LeoDJ/ledCollar/README.md

# LED Collar

### [PCB Documentation](ledCollar_PCB)

## Project Installation
Make sure to run `git clone` with `--recurse-submodules` to include the necessary libraries too.
