LeoDJ/ledCollar/ledCollar_PCB/README.md

# LED Collar PCB

### [Schematic PDF](ledCollar_PCB.pdf)
### [Interactive BOM](https://leodj.github.io/ledCollar/ledCollar_PCB/doc/ledCollar_PCB-ibom.html)

## Pictures

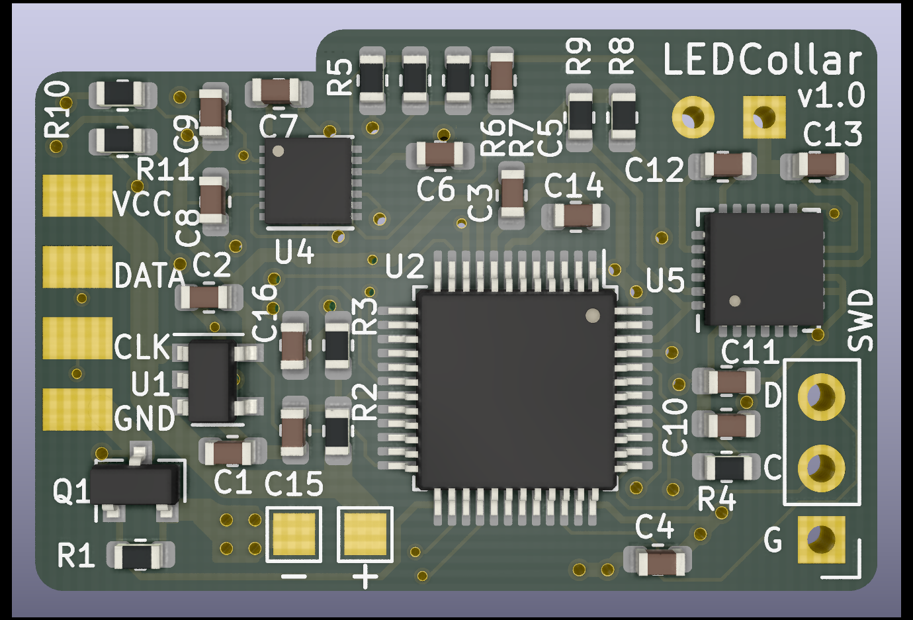
[picture p1: ledCollar_PCB/doc/1top.png]
front
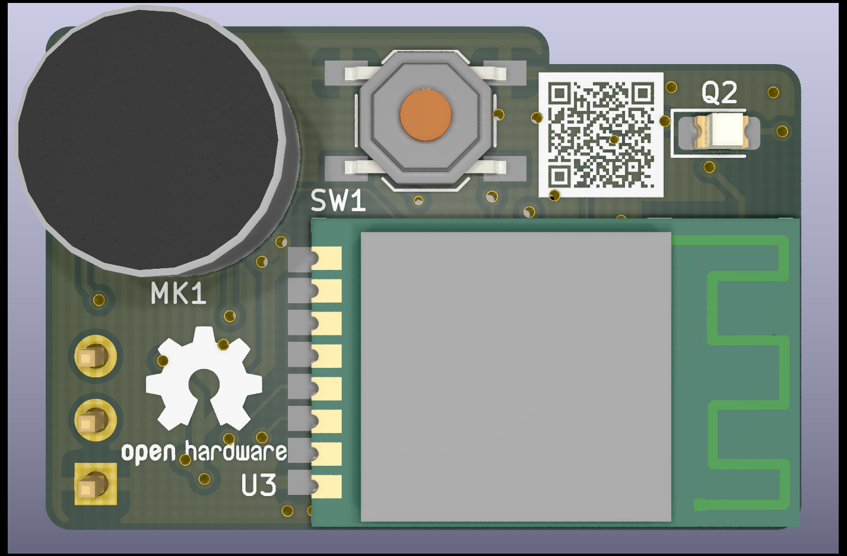
[picture p2: ledCollar_PCB/doc/1bot.png]
back
|  |  |
| --- | --- |
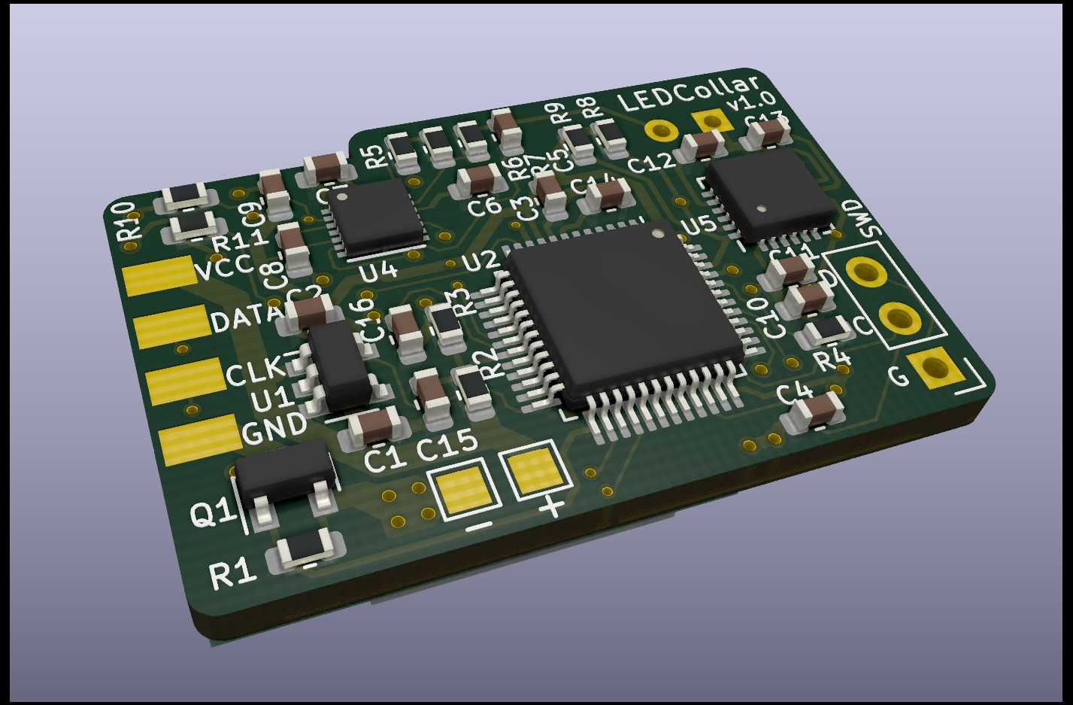
[picture p3: ledCollar_PCB/doc/2top.png]
front3D
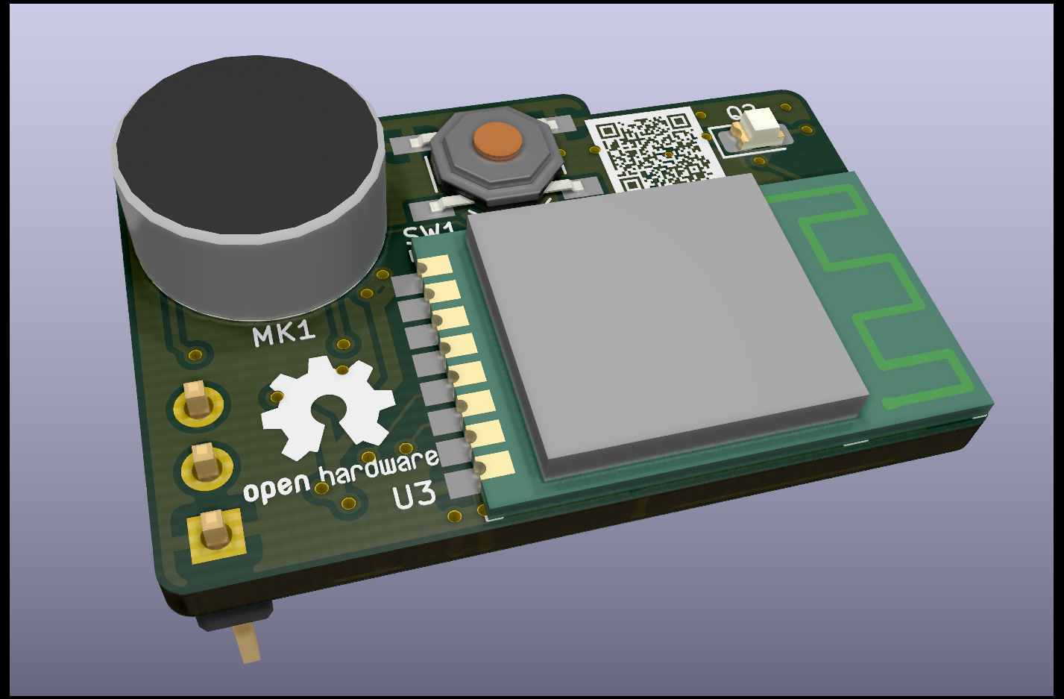
[picture p4: ledCollar_PCB/doc/2bot.png]
back3D
|  |  |

## Project Installation
Make sure to run `git clone` with `--recurse-submodules` to include the necessary libraries too.
