LeoDJ/ledCollar/ledCollar_PCB/doc/top_isometric.png

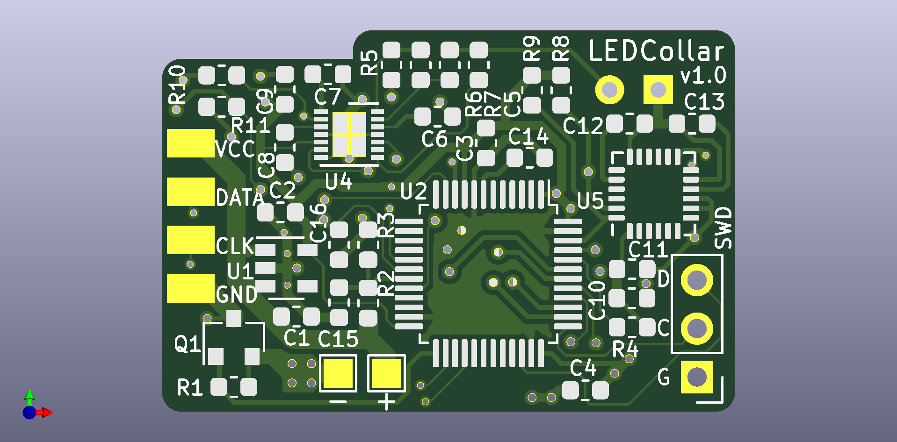
ledCollar_PCB/doc/top_isometric.png
