LeoDJ/ledCollar/ledCollar_PCB/case/ledCollar_Case_Top.stl

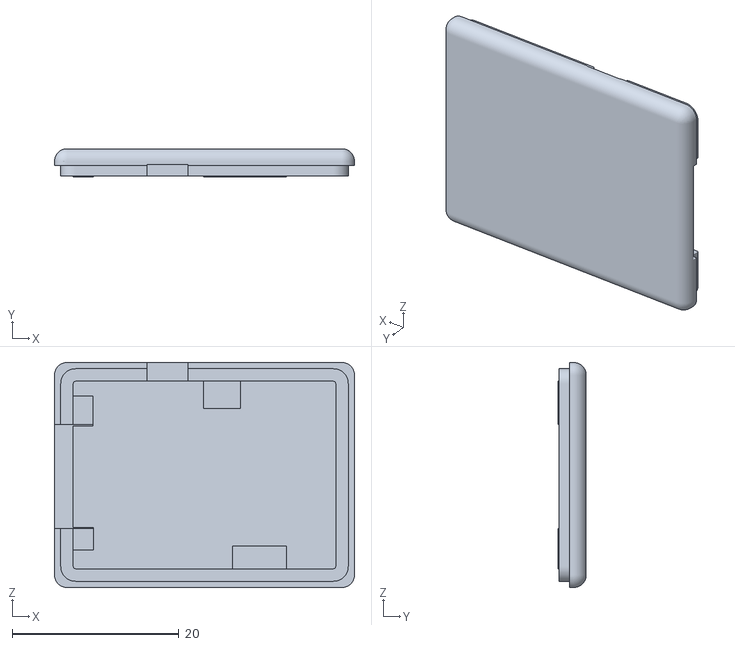
[picture p6: CAD file, 2020-08-19]
ledCollar_PCB/case/ledCollar_Case_Top.stl
36.0 x 3.42 x 27.0
