LeoDJ/ledCollar/ledCollar_PCB/case/ledCollar_Case_Bottom.stl

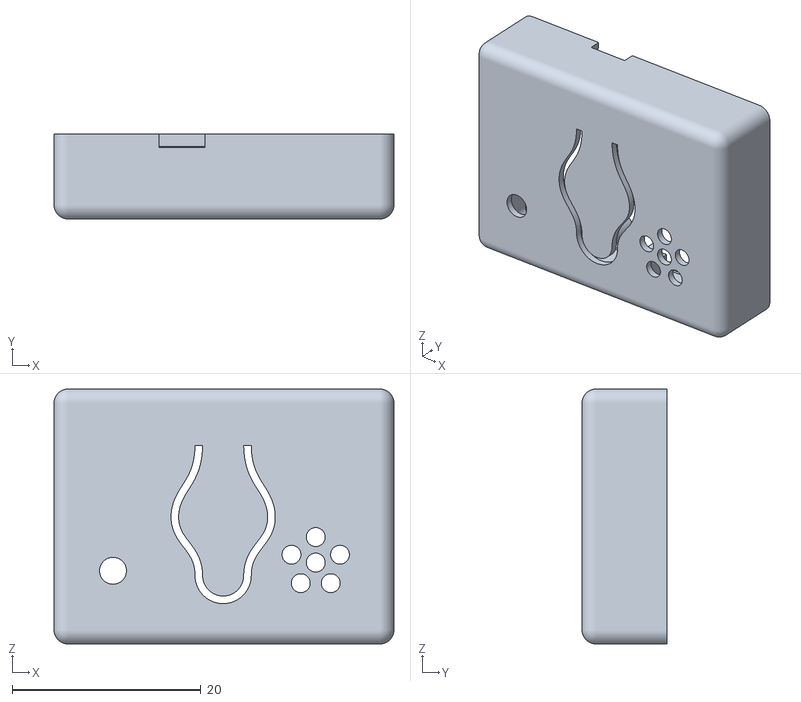
[picture p7: CAD file, 2020-08-19]
ledCollar_PCB/case/ledCollar_Case_Bottom.stl
36.0 x 9.00 x 27.0
