LeoDJ/ledCollar/ledCollar_PCB/ledCollar_PCB.pdf

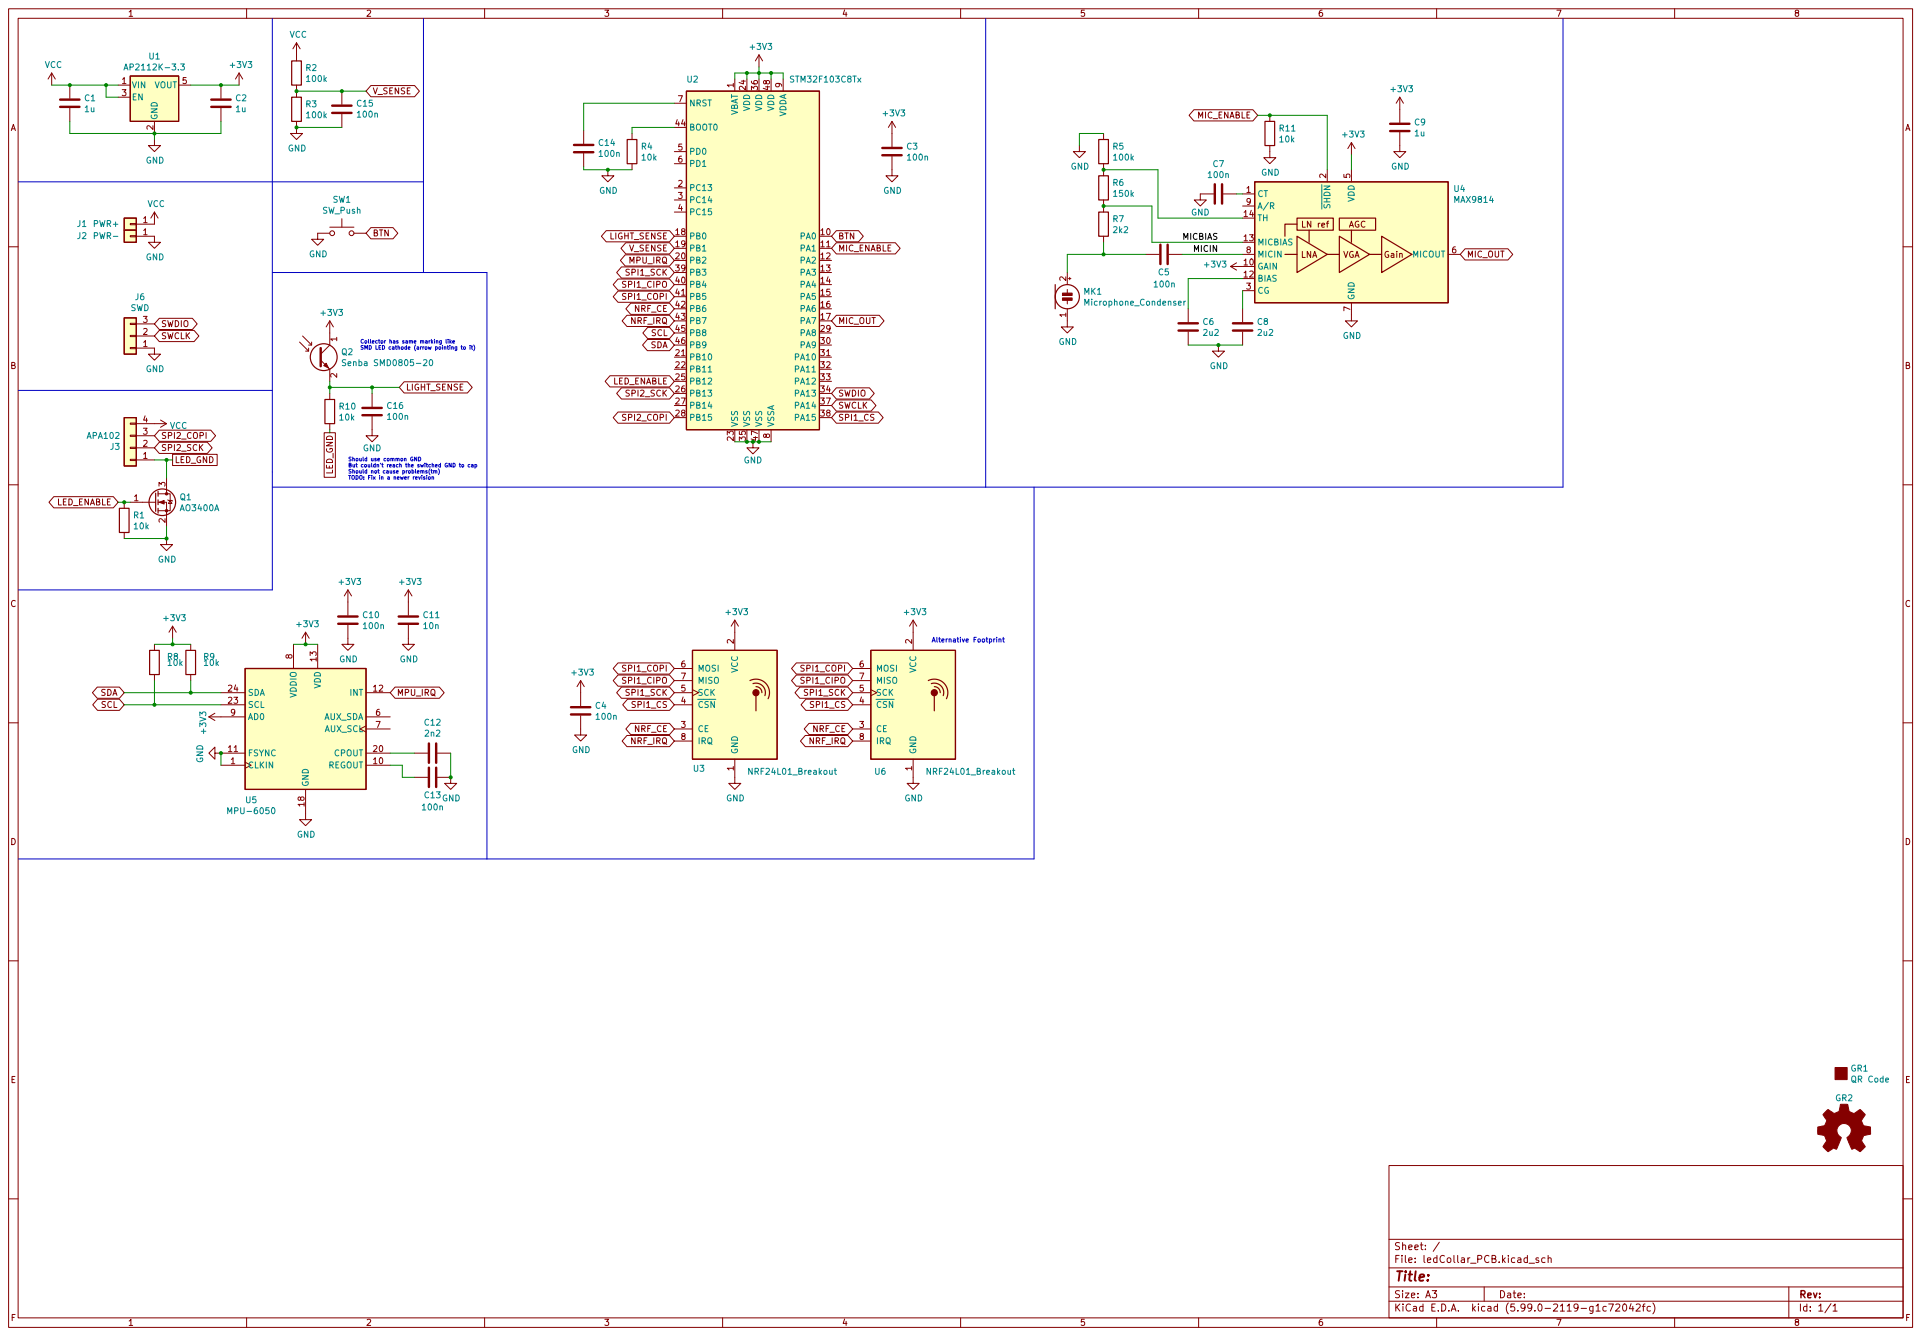
[picture p8: page 1]

1 VDD 24 VDD 36 VDD 48 VDDA

9 VSS 23 VSS 35 VSS 47 VSSA

LIGHT_SENSE

SPI1_CS NRF_IRQ

Should use common GND

2 CE 3 CSN 4 SCK 5 MOSI 6 MISO 7

SPI1_SCK NRF_CE
