LeoDJ/ledCollar/ledCollar_PCB/ledCollar_PCB.kicad_pcb

## KiCad design ledCollar_PCB/ledCollar_PCB.kicad_pcb (2020-07-24)

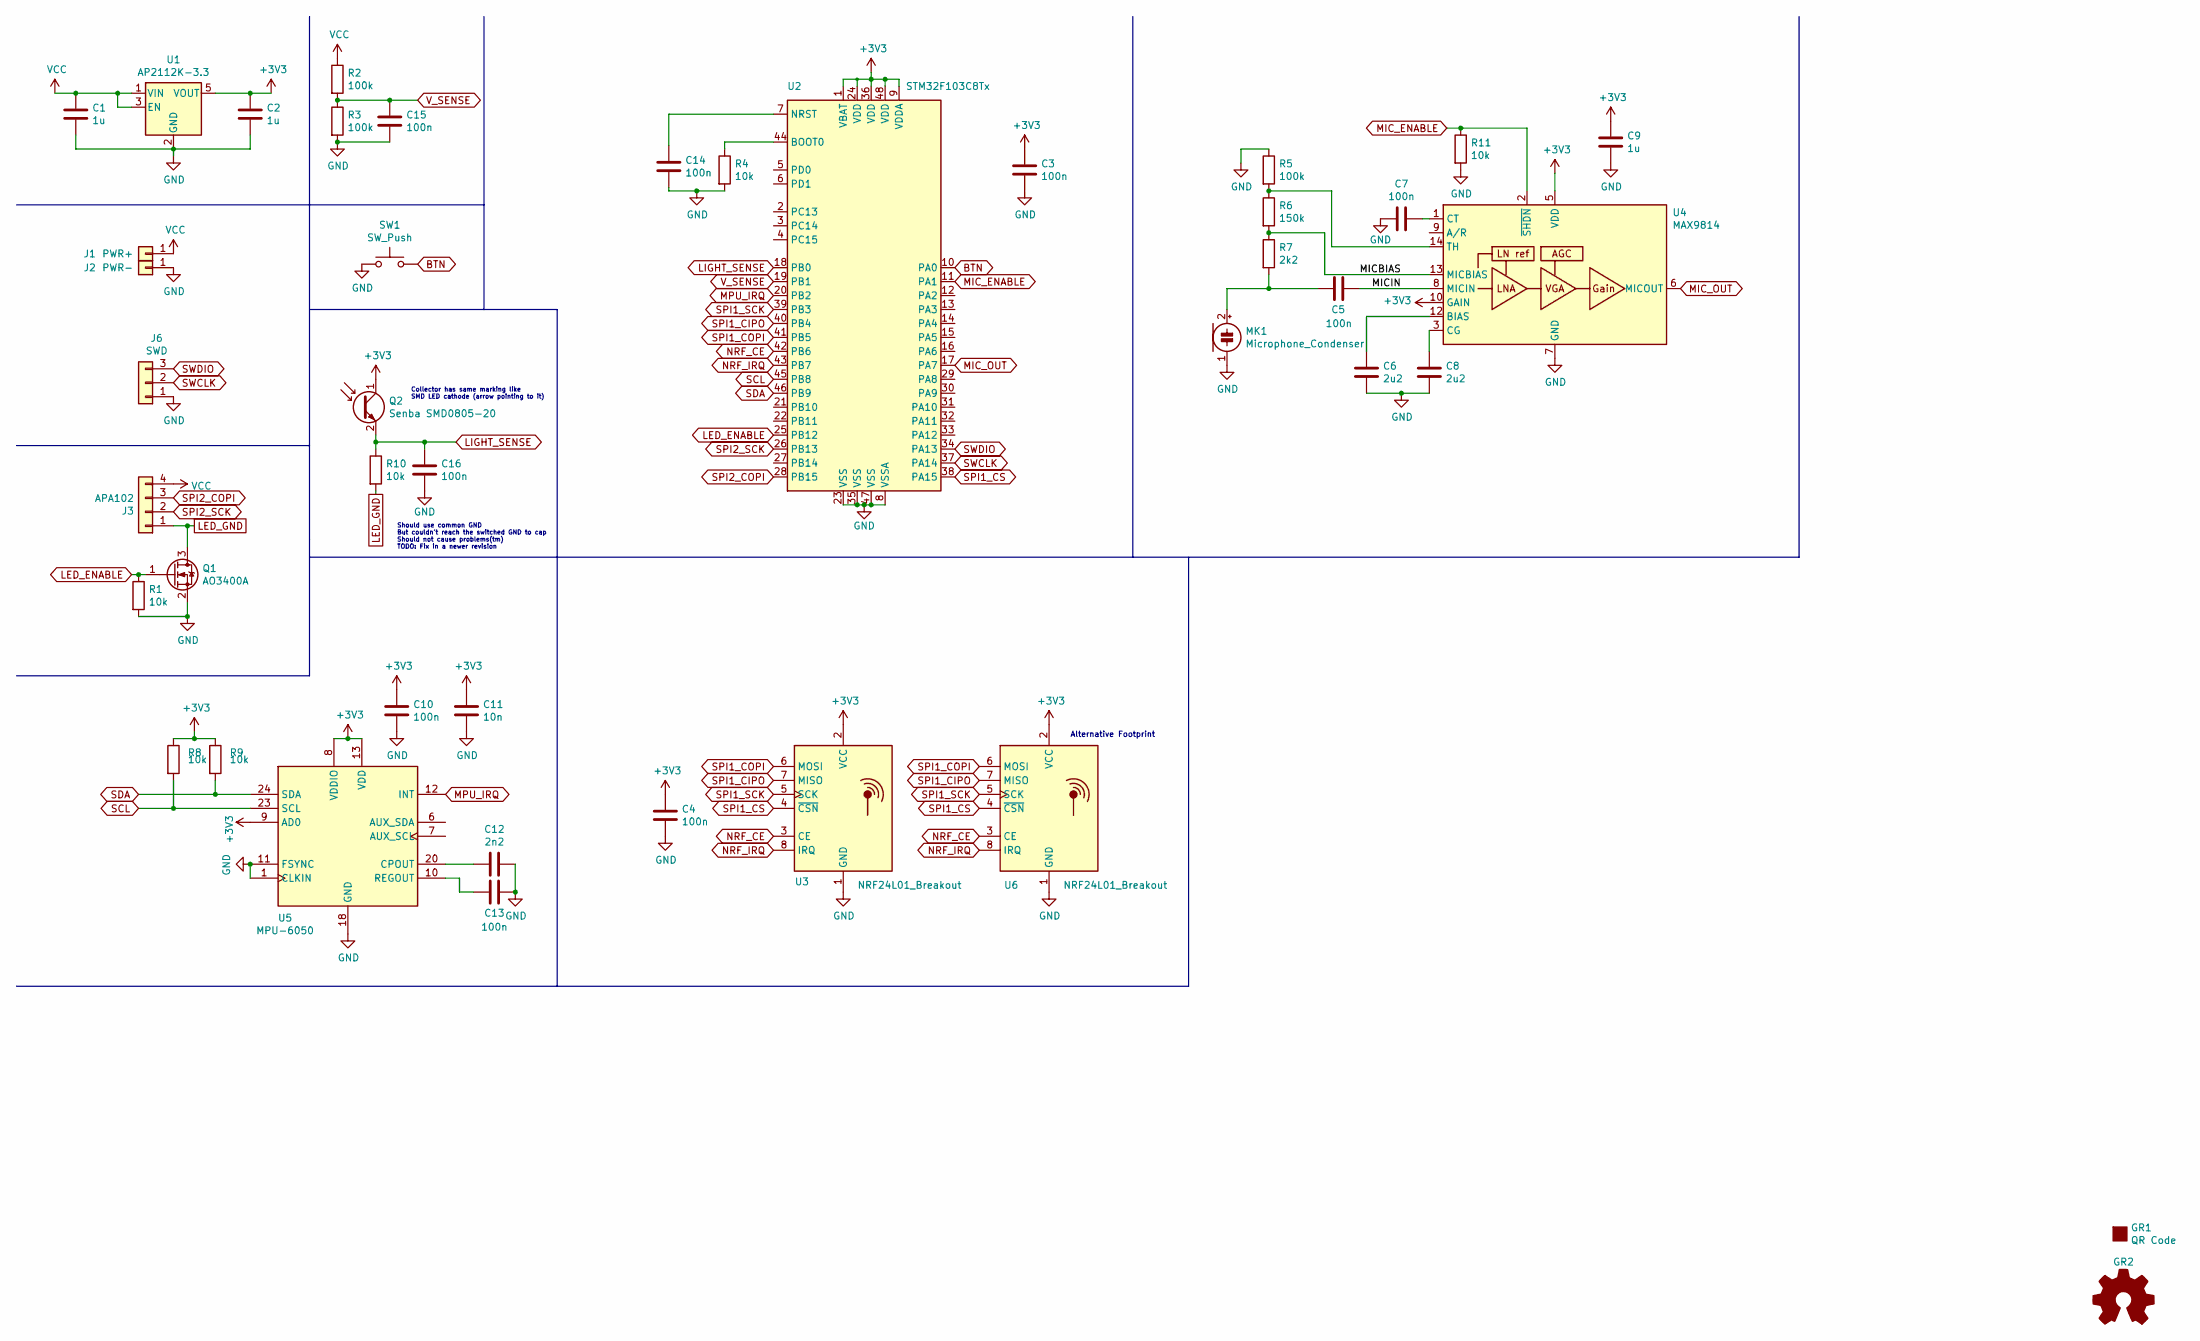
[picture p9: schematic ledCollar_PCB.kicad_sch]

Parts:
C1, C2, C9: 1u; C_0603_1608Metric
C3, C4, C5, C7, C10, C13, C14, C15, C16: 100n; C_0603_1608Metric
C6, C8: 2u2; C_0603_1608Metric
C11: 10n; C_0603_1608Metric
C12: 2n2; C_0603_1608Metric
GR1: QR Code; QR_Code_LEDCollar
GR2: Logo_Open_Hardware_Small; OSHW-Logo2_7.3x6mm_SilkScreen
J1: PWR+; TestPoint_Pad_1.5x1.5mm
J2: PWR-; TestPoint_Pad_1.5x1.5mm
J3: APA102; APA102_SolderPads
J6: SWD; PinHeader_1x03_P2.54mm_Vertical
MK1: Microphone_Condenser; Microphone_9.5mm
Q1: AO3400A; SOT-23
Q2: Senba SMD0805-20; LED_0805_2012Metric_Castellated
R1, R4, R8, R9, R10, R11: 10k; R_0603_1608Metric
R2, R3, R5: 100k; R_0603_1608Metric
R6: 150k; R_0603_1608Metric
R7: 2k2; R_0603_1608Metric
SW1: SW_Push; SW_SPST_TL3342
U1: AP2112K-3.3; SOT-23-5
U2: STM32F103C8Tx; LQFP-48_7x7mm_P0.5mm
U3: NRF24L01_Breakout; NRF24L01_E01-2G4M01S1B
U4: MAX9814; DFN-14-1EP_3x3mm_P0.4mm_EP1.78x2.35mm
U5: MPU-6050; InvenSense_QFN-24_4x4mm_P0.5mm
U6: NRF24L01_Breakout; NRF24L01_SMD_PadsOnly

Connections:
+3V3: C2.1, C3.1, C4.1, C9.1, C10.1, C11.1, Q2.1 (C), R8.1, R9.1, U1.5 (VOUT), U2.1 (VBAT), U2.9 (VDDA), U2.24 (VDD), U2.36 (VDD), U2.48 (VDD), U3.2 (VCC), U4.5 (VDD), U4.10 (GAIN), U5.8 (VDDIO), U5.9 (AD0), U5.13 (VDD), U6.2 (VCC)
/MICBIAS: R6.2, R7.1, U4.13 (MICBIAS)
/MICIN: C5.2, U4.8 (MICIN)
BTN: SW1.2, U2.10 (PA0)
GND: C1.2, C2.2, C3.2, C4.2, C6.2, C7.2, C8.2, C9.2, C10.2, C11.2, C12.2, C13.2, C14.1, C15.1, C16.1, J2.1, J6.1, MK1.1 (-), Q1.2 (S), R1.2, R3.2, R4.2, R5.1, R11.2, SW1.1, U1.2 (GND), U2.8 (VSSA), U2.23 (VSS), U2.35 (VSS), U2.47 (VSS), U3.1 (GND), U4.4 (GND), U4.7 (GND), U4.11 (GND), U4.15 (GND), U5.1 (CLKIN), U5.11 (FSYNC), U5.18 (GND), U6.1 (GND)
LED_ENABLE: Q1.1 (G), R1.1, U2.25 (PB12)
LED_GND: J3.1, Q1.3 (D), R10.2
LIGHT_SENSE: C16.2, Q2.2 (E), R10.1, U2.18 (PB0)
MIC_ENABLE: R11.1, U2.11 (PA1), U4.2 (~SHDN)
MIC_OUT: U2.17 (PA7), U4.6 (MICOUT)
MPU_IRQ: U2.20 (PB2), U5.12 (INT)
NRF_CE: U2.42 (PB6), U3.3 (CE), U6.3 (CE)
NRF_IRQ: U2.43 (PB7), U3.8 (IRQ), U6.8 (IRQ)
unnamed: C5.1, MK1.2 (+), R7.2
unnamed: C6.1, U4.12 (BIAS)
unnamed: C7.1, U4.1 (CT)
unnamed: C8.1, U4.3 (CG)
unnamed: C12.1, U5.20 (CPOUT)
unnamed: C13.1, U5.10 (REGOUT)
unnamed: C14.2, U2.7 (NRST)
unnamed: R4.1, U2.44 (BOOT0)
unnamed: R5.2, R6.1, U4.14 (TH)
SCL: R8.2, U2.45 (PB8), U5.23 (SCL)
SDA: R9.2, U2.46 (PB9), U5.24 (SDA)
SPI1_CIPO: U2.40 (PB4), U3.7 (MISO), U6.7 (MISO)
SPI1_COPI: U2.41 (PB5), U3.6 (MOSI), U6.6 (MOSI)
SPI1_CS: U2.38 (PA15), U3.4 (~CSN), U6.4 (~CSN)
SPI1_SCK: U2.39 (PB3), U3.5 (SCK), U6.5 (SCK)
SPI2_COPI: J3.3, U2.28 (PB15)
SPI2_SCK: J3.2, U2.26 (PB13)
SWCLK: J6.2, U2.37 (PA14)
SWDIO: J6.3, U2.34 (PA13)
VCC: C1.1, J1.1, J3.4, R2.1, U1.1 (VIN), U1.3 (EN)
V_SENSE: C15.2, R2.2, R3.1, U2.19 (PB1)

Notes on the sheet:
Should use common GND But couldn't reach the switched GND to cap Should not cause problems(tm) TODO: Fix in a newer revision
Collector has same marking like SMD LED cathode (arrow pointing to it)
Alternative Footprint

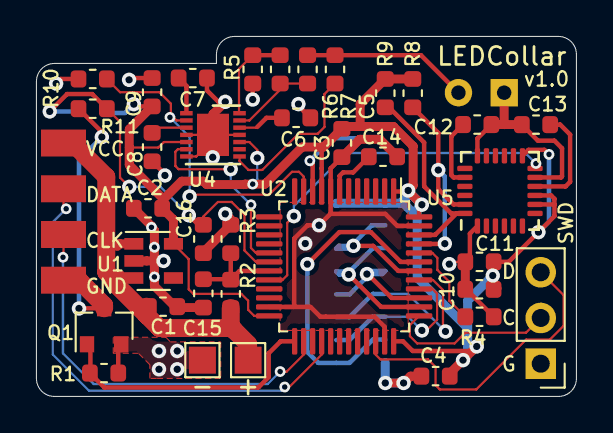
[picture p10: board ledCollar_PCB.kicad_pcb from above]

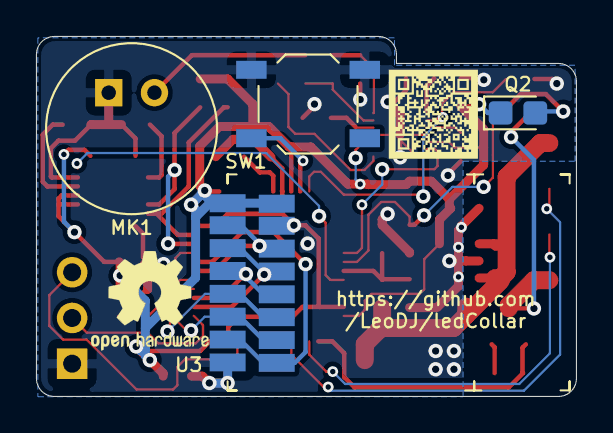
[picture p11: board ledCollar_PCB.kicad_pcb from below]

Board: 2 copper layers, 30.0 x 20.0 mm, 43 parts (7 on the bottom side), 34 nets.
