LeoDJ/ledCollar/ledCollar_Firmware/Src/main.cpp

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

/* Includes ------------------------------------------------------------------*/
#include "main.h"
#include "adc.h"
#include "dma.h"
#include "i2c.h"
#include "spi.h"
#include "usart.h"
#include "gpio.h"

/* USER CODE BEGIN Includes */
#include <stdio.h>

#include "globals.h"
#include "led.h"
#include "sound.h"
#include "util.h"
#include "button.h"
#include "analogSensors.h"
#include "apa102.h"
#include "system.h"

void SystemClock_Config(void);
void systemShutdown();

int main(void) {

    HAL_Init();           // Reset of all peripherals, Initializes the Flash interface and the Systick.
    SystemClock_Config(); // Configure the system clock

    // Initialize all configured peripherals
    MX_GPIO_Init();
    MX_DMA_Init();
    MX_SPI1_Init();
    MX_SPI2_Init();
    MX_USART1_UART_Init();
    MX_ADC1_Init();
    MX_USART2_UART_Init();
    MX_I2C1_Init();

    printf("LED Collar Startup...\n");

    HAL_ADCEx_Calibration_Start(&hadc1);

    initSound();
    initLed();

    HAL_GPIO_WritePin(MIC_ENABLE_GPIO_Port, MIC_ENABLE_Pin, GPIO_PIN_SET);
    HAL_GPIO_WritePin(LED_ENABLE_GPIO_Port, LED_ENABLE_Pin, GPIO_PIN_SET);

    // #define MAX_IDLE_COUNT  2255000 // ish
    // uint32_t idleCounter = 0, lastCpuCalc = 0;

    uint32_t lastTime = 0;

    while (1) {
        // if(HAL_GetTick() - lastCpuCalc > 1000) {
        //   lastCpuCalc = HAL_GetTick();
        //   int delta = MAX_IDLE_COUNT - (int)idleCounter;
        //   delta = delta < 0 ? 0 : delta;
        //   int cpu = (delta * 1000LL) / MAX_IDLE_COUNT;
        //   _printf("CPU usage estimation: %3d.%d%%\n", cpu/10, cpu%10);
        //   idleCounter = 0;
        // }
        // idleCounter++;

        loopLed();
        buttonLoop();
        analogSensorsLoop();
        systemLoop();
        // if(HAL_GetTick() - lastTime > 100) {
        //   lastTime = HAL_GetTick();
        // HAL_GPIO_TogglePin(LED_ENABLE_GPIO_Port, LED_ENABLE_Pin);
        // }
        // HAL_Delay(100);

        // HAL_Delay(1);

        // printf("test\n");

        // HAL_GPIO_TogglePin(GPIOC, GPIO_PIN_13);
        // for(int i = 0; i < NUM_MIC_SAMPLES; i++) {
        //   HAL_UART_Transmit(&PRINTF_UART, (uint8_t *)&micSamples[i], 2, 100);
        // }

        /* USER CODE END WHILE */

        /* USER CODE BEGIN 3 */
    }
}

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
