LeoDJ/ledCollar/ledCollar_Firmware/Src/cubemx/ledCollar_Firmware.ioc

Mcu.UserName=STM32F103C8Tx
PA0-WKUP.GPIO_Label=BTN
PA0-WKUP.Signal=GPXTI0
PA1.GPIO_Label=MIC_ENABLE
PA1.Signal=GPIO_Output
PA10.Signal=USART1_RX
PA13.Signal=SYS_JTMS-SWDIO
PA14.Signal=SYS_JTCK-SWCLK
PA15.Signal=SPI1_NSS
PA2.Signal=USART2_TX
PA3.Signal=USART2_RX
PA7.GPIO_Label=MIC_IN
PA7.Signal=ADCx_IN7
PA9.Signal=USART1_TX
PB0.GPIO_Label=LIGHT_SENSE
PB0.Signal=ADCx_IN8
PB1.GPIO_Label=VSense
PB1.Signal=ADCx_IN9
PB12.GPIO_Label=LED_ENABLE
PB12.Signal=GPIO_Output
PB13.Signal=SPI2_SCK
PB15.Signal=SPI2_MOSI
PB2.GPIO_Label=MPU_IRQ
PB2.Signal=GPIO_Input
PB3.Signal=SPI1_SCK
PB4.Signal=SPI1_MISO
PB5.Signal=SPI1_MOSI
PB6.GPIO_Label=NRF_CE
PB6.Signal=GPIO_Output
PB7.GPIO_Label=NRF_IRQ
PB7.Signal=GPIO_Input
PB8.Signal=I2C1_SCL
PB9.Signal=I2C1_SDA
PC13-TAMPER-RTC.GPIO_Label=LED_BUILTIN
PC13-TAMPER-RTC.Signal=GPIO_Output
