LeoDJ/ledCollar/(commit log)

2020-03-29 ADC DMA working
2020-03-29 ADC transfer complete callback working
2020-03-29 APA102 LEDs working
2020-04-06 import ledAnimation from other project
2020-04-06 workaround printf not being called for some reason
    [main.cpp, util.cpp, util.h]
2020-04-12 fix APA102 protocol quirk
    [apa102.cpp]
2020-07-02 try fixing Goertzel algorithm
    [sound.cpp, sound.h]
2020-07-02 move Goertzel algorithm to separate file also fixed the "bug", it was a uint16 overflow in the debug output
    [goertzel.cpp, goertzel.h, sound.cpp, sound.h]
2020-07-05 begin with PCB design
    [ledCollar_PCB.kicad_pcb, ledCollar_PCB.kicad_sch]
2020-07-08 some layout tweaks, nothing major
    [ledCollar_PCB.kicad_pcb, ledCollar_PCB.kicad_sch]
2020-07-09 pin definitions for PCB
2020-07-09 *layouting sounds*
    [ledCollar_PCB.kicad_pcb, ledCollar_PCB.kicad_sch]
2020-07-13 add light sensor
    [ledCollar_PCB.kicad_pcb, ledCollar_PCB.kicad_sch]
2020-07-20 add alternate NRF footprint
    [ledCollar_PCB.kicad_pcb, ledCollar_PCB.kicad_sch]
2020-07-20 PCB finishing touches
    [ledCollar_PCB.kicad_pcb, ledCollar_PCB.kicad_sch]
2020-07-20 export gerbers
    [ledCollar_PCB-B_Cu.gbr, ledCollar_PCB-B_Mask.gbr, ledCollar_PCB-B_Paste.gbr, ledCollar_PCB-B_SilkS.gbr, ledCollar_PCB-Edge_Cuts.gbr, ledCollar_PCB-F_Cu.gbr, ledCollar_PCB-F_Mask.gbr, ledCollar_PCB-F_Paste.gbr]
2020-07-23 add cap to STM32 reset pin
    [ledCollar_PCB-B_Cu.gbr, ledCollar_PCB-B_Mask.gbr, ledCollar_PCB-B_Paste.gbr, ledCollar_PCB-B_SilkS.gbr, ledCollar_PCB-Edge_Cuts.gbr, ledCollar_PCB-F_Cu.gbr, ledCollar_PCB-F_Mask.gbr, ledCollar_PCB-F_Paste.gbr]
2020-07-24 add ADC input bypass caps
    [ledCollar_PCB-B_Cu.gbr, ledCollar_PCB-B_Mask.gbr, ledCollar_PCB-B_Paste.gbr, ledCollar_PCB-B_SilkS.gbr, ledCollar_PCB-Edge_Cuts.gbr, ledCollar_PCB-F_Cu.gbr, ledCollar_PCB-F_Mask.gbr, ledCollar_PCB-F_Paste.gbr]
2020-07-24 fix quiescent current of MAX9814 and voltage dividers
    [ledCollar_PCB-B_Cu.gbr, ledCollar_PCB-B_Mask.gbr, ledCollar_PCB-B_Paste.gbr, ledCollar_PCB-B_SilkS.gbr, ledCollar_PCB-Edge_Cuts.gbr, ledCollar_PCB-F_Cu.gbr, ledCollar_PCB-F_Mask.gbr, ledCollar_PCB-F_Paste.gbr]
2020-07-24 add schematic link
2020-08-05 add trough filter
2020-08-19 add 3D printable enclosure for the PCB
    [ledCollar_Case_Bottom.stl, ledCollar_Case_Top.stl]
2020-08-19 change cubemx project to PCB pins & peripherals
2020-08-19 fix code to run on final PCB (mostly) ADC still not quite working correctly, UART questionable
    [apa102.h, led.cpp, main.cpp, sound.cpp, sound.h]
2020-08-21 add rudimentary button handling
2020-08-24 fix first LED not being lit
    [apa102.cpp]
2020-10-31 vu1 animation make last led change brightness
2021-08-21 switch to CubeMX provided libraries
2021-08-22 implement analog sensor reading
2021-08-22 implement accurate voltage reading
2021-08-23 begin refactoring button handling
2021-09-11 fix automatic brightness loop
    [ledAnimation.cpp, system.cpp]
2021-09-12 implement standby on long button press
2021-09-21 improve standby current a bit
    - disable ADC (-1mA)
    - set free GPIOs to analog in (-0.5mA)
    Still not as low as I'd like at 1.9mA, target is <200µA
    STM still takes at least 1mA, the other 1mA is from somewhere else (NRF24?)
2021-10-15 hack in automatic animation switch + manual brightness control
2021-10-15 improve button handling
2021-10-15 calibrate auto brightness
2021-10-15 implement random animation switching & make AGC faster
2023-02-18 implement showing battery level at boot (untested)
